bugg-resources/bugg-cables/housing-cable-assy/images/assy.jpg

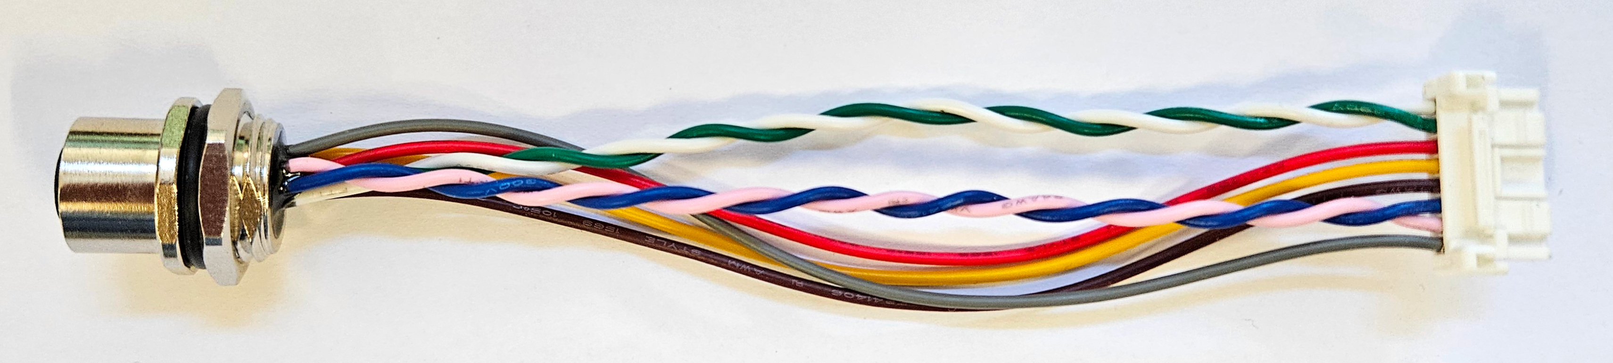
housing-cable-assy/images/assy.jpg
