bugg-resources/bugg-cables/housing-cable-assy/images/TE-T4171320008-001.jpg

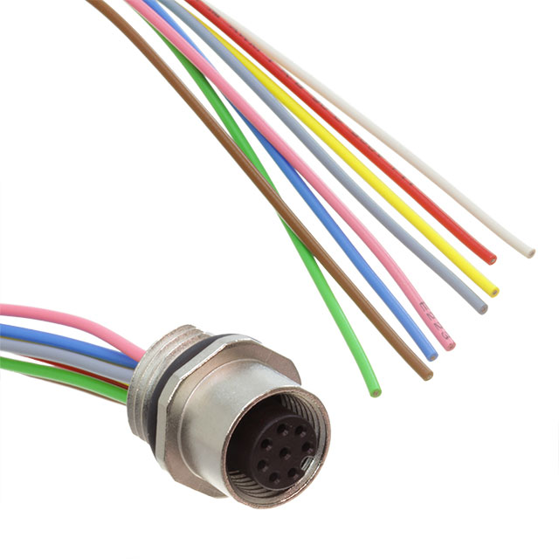
housing-cable-assy/images/TE-T4171320008-001.jpg
