bugg-resources/bugg-cables/housing-cable-assy/images/20240109_122958.jpg

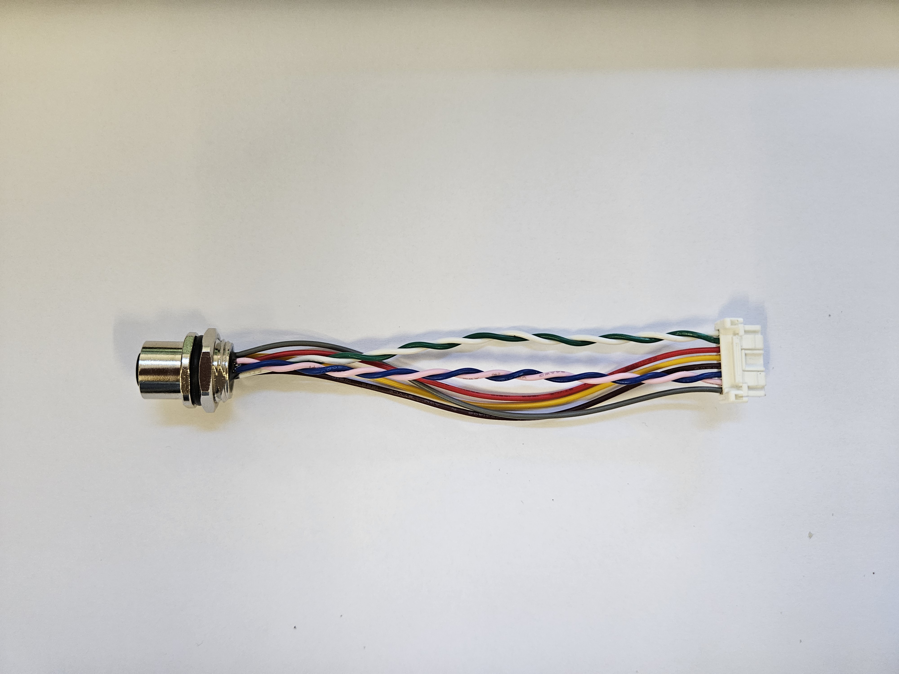
housing-cable-assy/images/20240109_122958.jpg
