bugg-resources/bugg-cables/power-and-pip-trs/m12-grommet.step

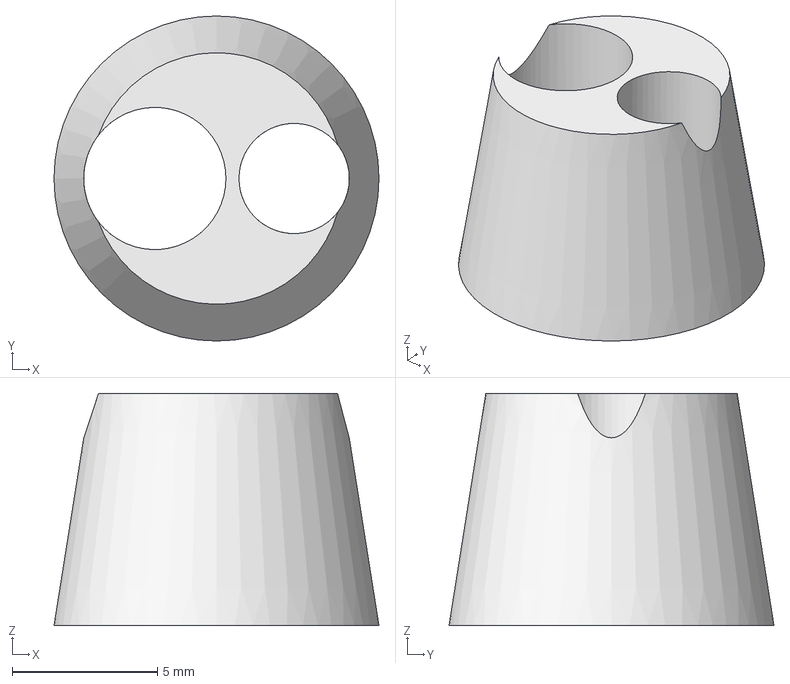
[picture p7: CAD file, 2024-10-03]
power-and-pip-trs/m12-grommet.step
11.2 x 11.2 x 8.00 mm
