bugg-resources/bugg-cables/(list of files, cad)

Other CAD files:
power-and-pip-trs/m12-grommet.3mf
power-and-pip-trs/m12-grommet.FCStd
