bugg-resources/bugg-cables/(commit log)

2024-10-01 Grommet for sealing power and TRS cables into TE screw-mount M12 connector
    [m12-grommet.FCStd, m12-grommet.step]
2024-10-03 Bambu slicer project fil e
    [m12-grommet.3mf]
2024-10-03 Grommet as finally printed - minimised hole spacing for single printed wall width between holes
    [m12-grommet.FCStd, m12-grommet.step]
2024-10-03 Arduino sketch for the cable test bed
2024-11-07 Grommet design as printed
    [m12-grommet.3mf]
2024-11-07 Add button
2024-11-07 Add housing cable M12-to-ClikMate
